TaiyouKomazawa16/MDController_v3/etc/MDController_sch.png

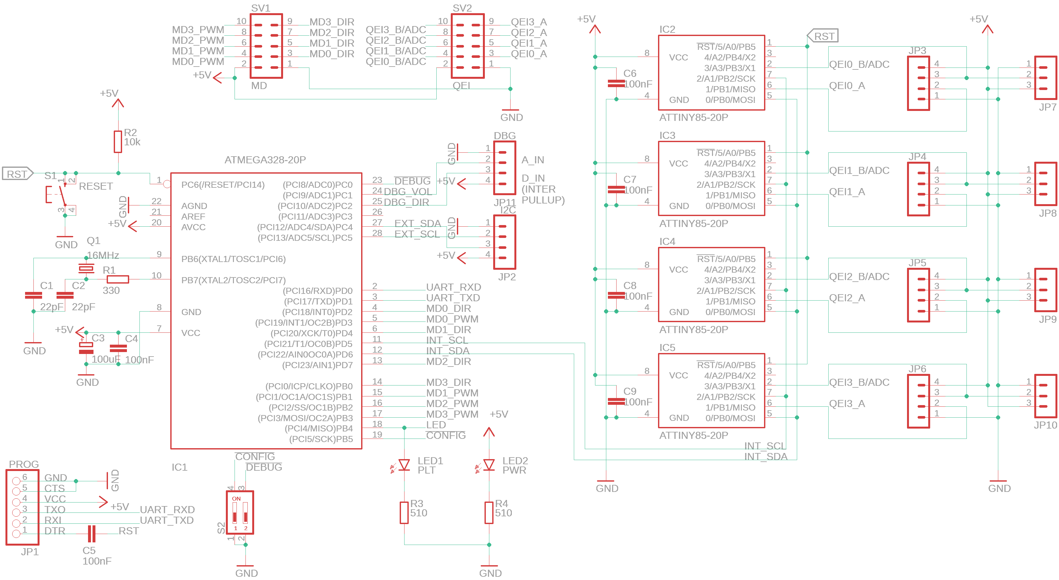
etc/MDController_sch.png
