TaiyouKomazawa16/MDController_v3/hardware/ATTinyCore/avr/extras/Pinout_1634.jpg

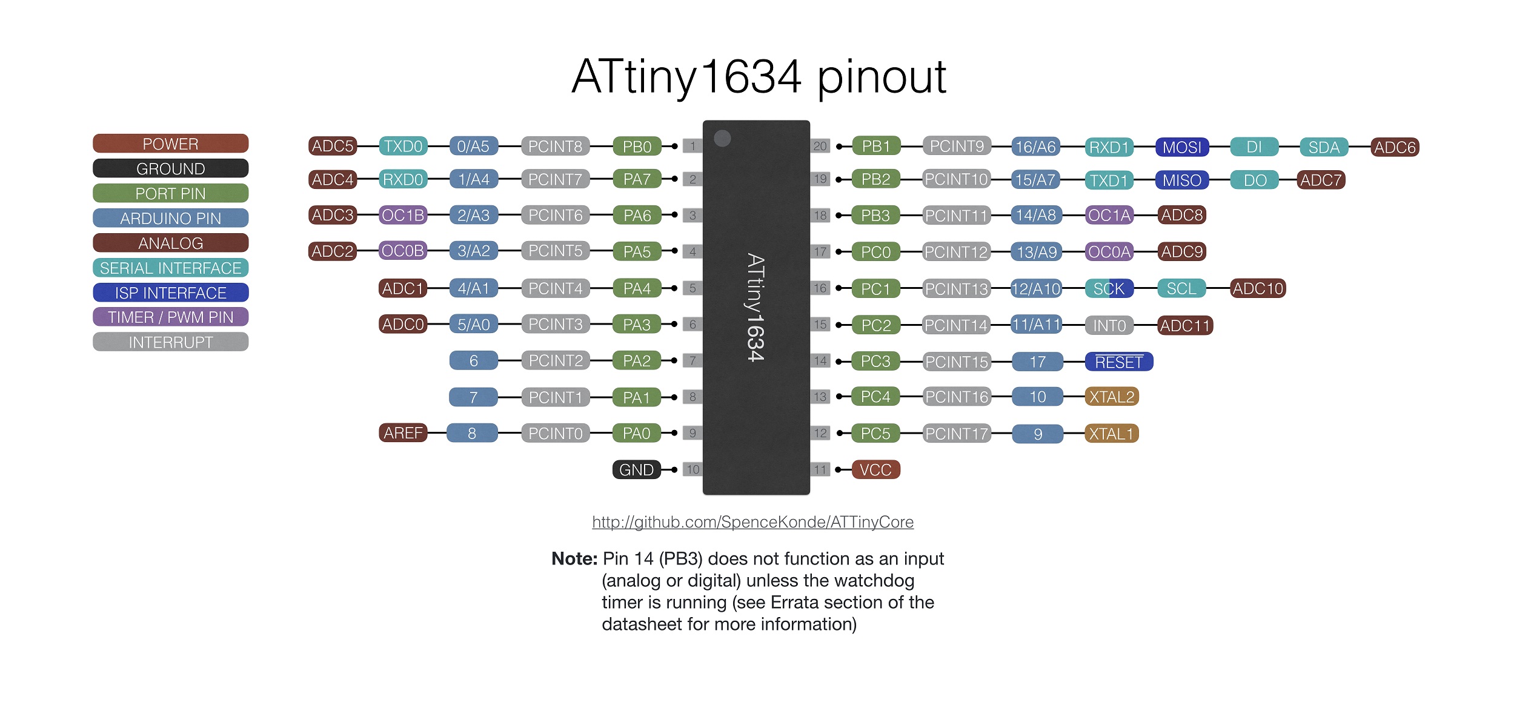
hardware/ATTinyCore/avr/extras/Pinout_1634.jpg
