TaiyouKomazawa16/MDController_v3/hardware/ATTinyCore/avr/extras/Pinout_x5.jpg

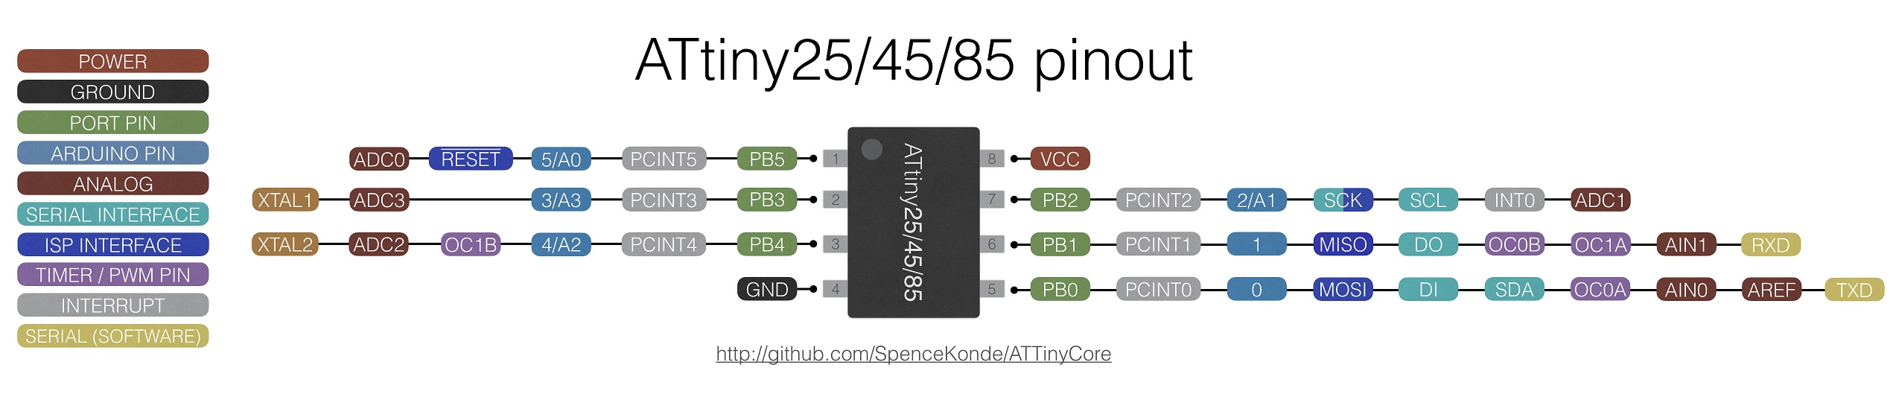
hardware/ATTinyCore/avr/extras/Pinout_x5.jpg
