TaiyouKomazawa16/MDController_v3/hardware/ATTinyCore/avr/extras/Pinout_x8-PU.jpg

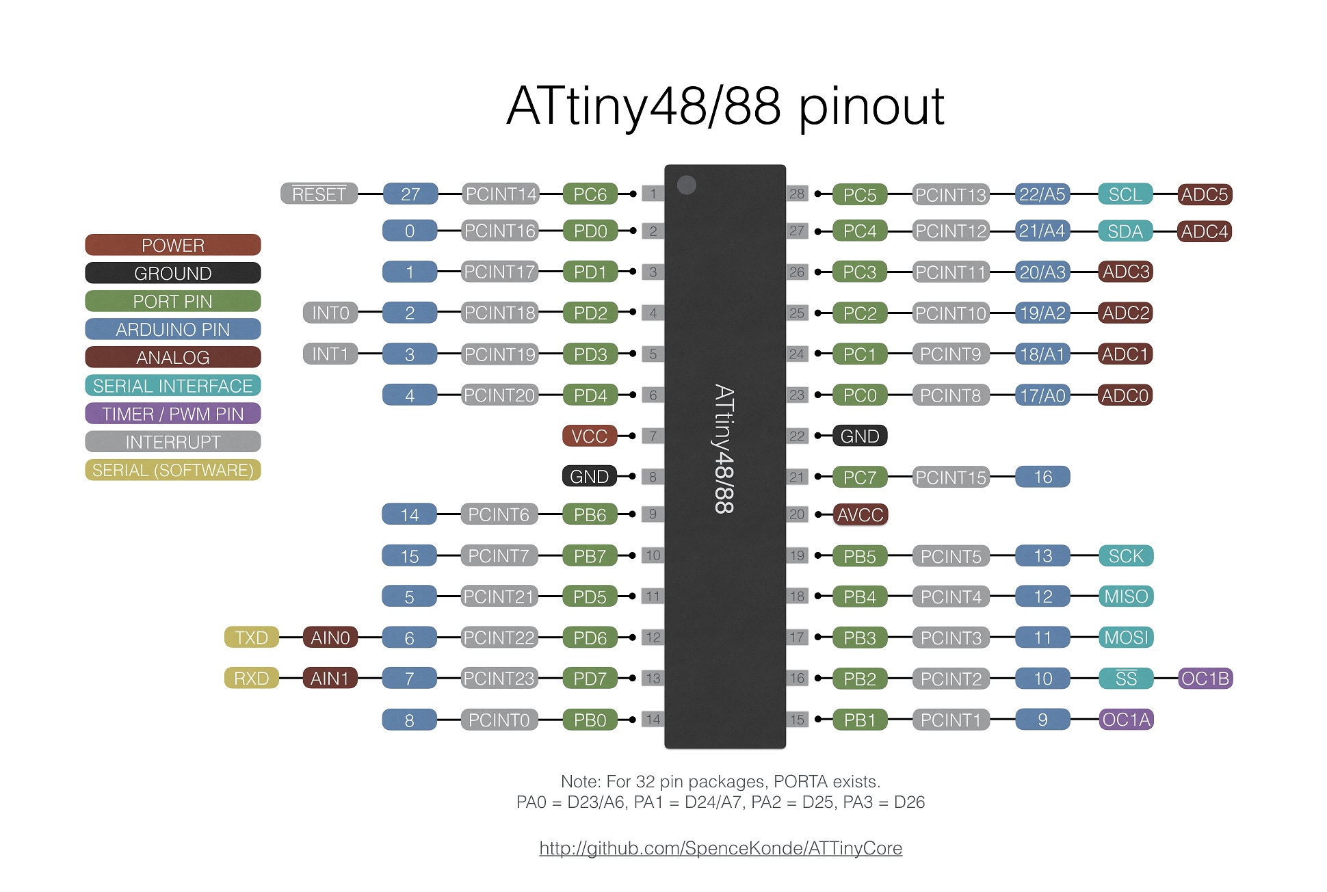
hardware/ATTinyCore/avr/extras/Pinout_x8-PU.jpg
