TaiyouKomazawa16/MDController_v3/(commit log)

2020-03-19 [移動] MDControllerプロジェクトをフォルダにまとめた
2020-03-19 [新規] オリジナルをこのプロジェクト用に変更を加えて追加
    keywords.txt
    boards.local.txt
    platform.local.txt
    をファーム直下に追加している
    参照: https://github.com/SpenceKonde/ATTinyCore.git
2020-03-20 [修正] 変更点がオリジナルのATTinyCoreに問題を与えないように修正した
2020-03-20 [新規] リリースに必要な最低限の文章を追加
2020-03-22 [修正] README.mdの書式の修正 README.md を Bitbucket 上でオンラインで編集しました。
2020-03-22 [修正] README.mdに掲載されている画像の軽量化
    bmp形式→png形式
2020-03-22 [新規] 通信についての説明を追加
2020-03-22 [修正] MDController_v3_i2c_protocol.mdの書式の修正 MDController_v3_i2c_protocol.md を Bitbucket 上でオンラインで編集しました。
2020-03-22 [変更] 出力した英文のフォーマットをそろえた
2020-03-22 [修正(緊急)] 致命的な欠陥があったので修正
    git管理前のコードの整形時に動作開始用の関数を書き忘れた模様
2020-03-22 [修正] README序文の表現の振れと内容を修正した。
2020-03-23 [修正] I2Cの手続きの修正
2020-03-23 [変更] 各ノードのコールバックをinline指定した。
2020-03-24 [整形] 割込みの手続きを最適化
    使用する型を絞った。
    途中式のための変数宣言を省略
2020-03-24 [修正] メイン周りの細かな修正
2020-03-24 [追加] 最適化オプションを変更したavr_boardを追加
    -Os → -O2へ変更、速度優先のコンパイルオプション
2020-03-24 [修正] Warningが出た部分のチェック
2020-03-24 [追加] 再送設定と返信リストにデータがない場合の例外処理を追加
